brzyzek/horologe/README.md

# horologe
A watch utilizing an ESP32 processor.
