brzyzek/horologe/2_HARDWARE/02_BOM/embd-watch-BOM-0001.ods

LEVEL | FIND NUMBER | PART NUMBER | PART DESCRIPTION | REF DES | QUANTITY | UOM | UNIT PRICE | PRICE | VENDOR LINK | PHASE | COMMENT
1 | 0001 | brzk-wt-001 | Embedded Watch Prototype |  | 1 | EACH |  | 48.226468 | N/A | PROTOTYPE
2 | 0001 | brzk-wt-001-pcb | Embedded Watch Prototype Printed Circuit Board |  | 1 | EACH | TBD | TBD | TBD | PROTOTYPE
2 | 0002 | ESP32-WROOM-32E-N4 | ESP32 Module /w PCB Antenna | U1 | 1 | EACH | $2.50 | $2.50 | https://www.digikey.com/en/products/detail/espressif-systems/ESP32-WROOM-32E-N4/11613125 | ACTIVE | NOT IN STOCK DIGIKEY!
2 | 0003 | XC9265A331MR-G | Voltage Regulator - 3.3V, DC-DC Converter | U2 | 1 | EACH | $1.46 | $1.46 | https://www.mouser.com/ProductDetail/Torex-Semiconductor/XC9265A331MR-G?qs=AsjdqWjXhJ9U1u7bKcUHSA%3D%3D | ACTIVE | CHECK CURRENT
2 | 0004 | MAX1811ESA+ | Battery Charger IC Lithium Ion | U3 | 1 | EACH | $4.82 | $4.82 | https://www.digikey.com/en/products/detail/analog-devices-inc-maxim-integrated/MAX1811ESA/1513383 | ACTIVE
2 | 0005 | TLV840MAPL36DBVRQ1 | Battery Supervisor IC | U4 | 1 | EACH | $0.85 | $0.85 | https://www.mouser.com/ProductDetail/Texas-Instruments/TLV840MAPL36DBVRQ1?qs=TuK3vfAjtkUvm%2FFmAPUHzQ%3D%3D | ACTIVE
2 | 0006 | DMC2400UV-7 | MOSFET N/P 2 CHANNEL PAIR IC | U5 | 1 | EACH | $0.40 | $0.40 | https://www.digikey.com/en/products/detail/diodes-incorporated/DMC2400UV-7/2918383 | ACTIVE | NEED TO ADD RESISTORS
2 | 0007 | LSM6DSMTR | IMU ACCEL/GYRO I2C/SPI IC | U6 | 1 | EACH | $4.45 | $4.45 | https://www.digikey.com/en/products/detail/stmicroelectronics/LSM6DSMTR/6192777 | ACTIVE
2 | 0008 | LPS22DFTR | Pressure Sensor | U7 | 1 | EACH | $4.19 | $4.19 | https://www.mouser.com/ProductDetail/STMicroelectronics/LPS22DFTR?qs=XAiT9M5g4x%2FrfsCWzyhaPw%3D%3D | ACTIVE
2 | 0009 | JS102011SAQN | SPDT SLIDE SWITCH RIGHT ANGLE | S1 | 1 | EACH | $0.71 | $0.71 | https://www.digikey.com/en/products/detail/c-k/JS102011SAQN/1640095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 | ACTIVE
2
2 |  | SM13B-GHS-TB(LF)(SN) | GH1.25 13 PIN 1.25MM CONNECTOR (FOR SCREEN MODULE) | J1 | 1 | EACH | 0.036468 | $0.04 | https://www.digikey.com/en/products/detail/jst-sales-america-inc/SM13B-GHS-TB-LF-SN/807797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 | ACTIVE | MAY NEED TO FIND ALTERNATE (STRAIGHT SOLDER?)
2 |  | USB4056-03-A | USB-C 3.2 CONNECTOR | J2 | 1 | EACH | $0.97 | $0.97 | https://www.digikey.com/en/products/detail/gct/USB4056-03-A/14638038 | ACTIVE
2 |  | GRPB052VWVN-RC | 10 PIN HEADER 2 ROW 1.27MM PITCH (JTAG) | J3 | 1 | EACH | $0.73 | $0.73 | https://www.digikey.com/en/products/detail/sullins-connector-solutions/GRPB052VWVN-RC/1786455 | ACTIVE
2
2
2
2 | 0201 | 24155 | 1.28 Inch 240x240p Screen Module /w Capacative Touch Sensor |  | 1 | EACH | $18.99 | $18.99 | https://www.waveshare.com/1.28inch-touch-lcd.htm | ACTIVE
2 | 0202 | LP851719JU+PCM+2 WIRES 50MM | LIPO 3.7V 180MAH BATTERY |  | 1 | EACH | $8.12 | $8.12 | https://www.digikey.com/en/products/detail/jauch-quartz/LP851719JU-PCM-2-WIRES-50MM/9560975 | ACTIVE
2 | 1001 | brzk-wt-001-sch | Embedded Watch Circuit Card Assembly Schematic |  | 0 | REF | N/A | N/A | N/A | PROTOTYPE
 |  |  | LSM6DSM
