brzyzek/horologe/2_HARDWARE/02_BOM/embd-watch-BOM-0002.ods

LEVEL | FIND NUMBER | PART NUMBER | PART DESCRIPTION | REF DES | QUANTITY | UOM | UNIT PRICE | PRICE | VENDOR LINK | PHASE | COMMENT
RC0603FR-070RL | 0001 | brzk-wt-001 | Embedded Watch Prototype |  | 1 | EACH |  | 55.496468 | N/A | PROTOTYPE
2 | 0001 | brzk-wt-001-pcb | Embedded Watch Prototype Printed Circuit Board |  | 1 | EACH | TBD | TBD | TBD | PROTOTYPE
2 | 0002 | ESP32-WROOM-32E-N4 | ESP32 Module /w PCB Antenna | U1 | 1 | EACH | $2.50 | $2.50 | https://www.digikey.com/en/products/detail/espressif-systems/ESP32-WROOM-32E-N4/11613125 | ACTIVE | NOT IN STOCK DIGIKEY!
2 | 0003 | XC9236A33CMR-G | Voltage Regulator - 3.3V, DC-DC Converter | U2 | 1 | EACH | $1.83 | $1.83 | https://www.mouser.com/ProductDetail/Torex-Semiconductor/XC9236A33CMR-G?qs=AsjdqWjXhJ%2FEQcsIJZieHw%3D%3D | ACTIVE | CHECK CURRENT
2 | 0004 | MAX1811ESA+ | Battery Charger IC Lithium Ion | U3 | 1 | EACH | $4.82 | $4.82 | https://www.digikey.com/en/products/detail/analog-devices-inc-maxim-integrated/MAX1811ESA/1513383 | ACTIVE
2 | 0005 | TLV840MAPL36DBVRQ1 | Battery Supervisor IC | U4 | 1 | EACH | $0.85 | $0.85 | https://www.mouser.com/ProductDetail/Texas-Instruments/TLV840MAPL36DBVRQ1?qs=TuK3vfAjtkUvm%2FFmAPUHzQ%3D%3D | ACTIVE
2 | 0006 | DMC2400UV-7 | MOSFET N/P 2 CHANNEL PAIR IC | U5 | 1 | EACH | $0.40 | $0.40 | https://www.digikey.com/en/products/detail/diodes-incorporated/DMC2400UV-7/2918383 | ACTIVE | NEED TO ADD RESISTORS
2 | 0007 | LSM6DSMTR | IMU ACCEL/GYRO I2C/SPI IC | U6 | 1 | EACH | $4.45 | $4.45 | https://www.digikey.com/en/products/detail/stmicroelectronics/LSM6DSMTR/6192777 | ACTIVE
2 | 0008 | LPS22DFTR | Pressure Sensor | U7 | 1 | EACH | $4.19 | $4.19 | https://www.mouser.com/ProductDetail/STMicroelectronics/LPS22DFTR?qs=XAiT9M5g4x%2FrfsCWzyhaPw%3D%3D | ACTIVE
2 | 0009 | JS102011SAQN | SPDT SLIDE SWITCH RIGHT ANGLE | S1 | 1 | EACH | $0.71 | $0.71 | https://www.digikey.com/en/products/detail/c-k/JS102011SAQN/1640095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 | ACTIVE
2
2 | 0010 | SM13B-GHS-TB(LF)(SN) | GH1.25 13 PIN 1.25MM CONNECTOR (FOR SCREEN MODULE) | J1 | 1 | EACH | 0.036468 | $0.04 | https://www.digikey.com/en/products/detail/jst-sales-america-inc/SM13B-GHS-TB-LF-SN/807797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 | ACTIVE | MAY NEED TO FIND ALTERNATE (STRAIGHT SOLDER?)
2 | 0011 | USB4056-03-A | USB-C 3.2 CONNECTOR | J2 | 1 | EACH | $0.97 | $0.97 | https://www.digikey.com/en/products/detail/gct/USB4056-03-A/14638038 | ACTIVE
2 | 0012 | GRPB052VWVN-RC | 10 PIN HEADER 2 ROW 1.27MM PITCH (JTAG) | J3 | 1 | EACH | $0.73 | $0.73 | https://www.digikey.com/en/products/detail/sullins-connector-solutions/GRPB052VWVN-RC/1786455 | ACTIVE
2
2 |  |  |  |  |  |  |  |  |  | ACTIVE
2 | 0100 | RC0603FR-075K1L | RESISTOR, 0603, 5.1K | R1,2 | 2 | EACH | $0.10 | $0.20 | https://www.mouser.com/ProductDetail/YAGEO/RC0603FR-075K1L | ACTIVE
2 | 0101 | RC0603FR-0710KL | RESISTOR, 0603, 10K | R3,4,5,17,20 | 5 | EACH | $0.10 | $0.50 | https://www.mouser.com/ProductDetail/YAGEO/RC0603FR-0710KL?qs=grNVn54RoB%252B3GtjbJj3wJQ%3D%3D | ACTIVE
2 | 0102 | RC0603FR-071KL | RESISTOR, 0603, 1K | R10,11 | 2 | EACH | $0.10 | $0.20 | https://www.mouser.com/ProductDetail/YAGEO/RC0603FR-071KL?qs=VU8sRB4EgwApHsk4rF%2F3zg%3D%3D | ACTIVE
2 | 0103 | RC0603FR-071ML | RESISTOR, 0603, 1M | R6,9 | 2 | EACH | $0.10 | $0.20 | https://www.mouser.com/ProductDetail/YAGEO/RC0603FR-071ML?qs=VU8sRB4EgwDPceeQKB324w%3D%3D | ACTIVE
2 | 0104 | RC0603FR-071M5L | RESISTOR, 0603, 1.5M | R7 | 1 | EACH | $0.10 | $0.10 | https://www.mouser.com/ProductDetail/YAGEO/RC0603FR-071M5L?qs=VU8sRB4EgwAP38Z8qzPx9Q%3D%3D | ACTIVE
2 | 0105 | RC0603FR-07180KL | RESISTOR, 0603, 180K | R8 | 1 | EACH | $0.10 | $0.10 | https://www.mouser.com/ProductDetail/YAGEO/RC0603FR-07180KL?qs=O8xBZ6PjLLQzC0EvPkFa3w%3D%3D | ACTIVE
2 | 0106 | RC0603FR-070RL | RESISTOR, 0603, 0R | R12,13,14,15,16,18,19 | 7 | EACH | $0.10 | $0.70 | https://www.mouser.com/ProductDetail/YAGEO/RC0603FR-070RL?qs=sGAEpiMZZMvdGkrng054t8AJgcdMkx7xZdNoPBh6LNc%3D | ACTIVE
2 | 0108 | NR4018T4R7M | INDUCTOR, NR4018, 4.7UH | L1 | 1 | EACH | $0.35 | $0.35 | https://www.digikey.com/en/products/detail/taiyo-yuden/NR4018T4R7M/958054 | END OF LIFE
2 | 0109 | CL21A475KPFNNNF | CAPACITOR, 0805, 4.7UF | C1,3,8,12 | 4 | EACH | $0.10 | $0.40 | https://www.mouser.com/ProductDetail/Samsung-Electro-Mechanics/CL21A475KPFNNNF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 | ACTIVE
 | 0110 | CL21B225KPFNNNE | CAPACITOR, 0805, 2.2UF | C2 | 1 | EACH | $0.10 | $0.10 | https://www.mouser.com/ProductDetail/Samsung-Electro-Mechanics/CL21B225KPFNNNE?qs=349EhDEZ59oD5pfAKZ0J0g%3D%3D | ACTIVE
 | 0111 | CL21A106KQFNNNE | CAPACITOR, 0805, 10UF | C4 | 1 | EACH | $0.10 | $0.10 | https://www.mouser.com/ProductDetail/Samsung-Electro-Mechanics/CL21A106KQFNNNE?qs=349EhDEZ59r7ASo3FF1ozQ%3D%3D | ACTIVE
 | 0112 | CL21B104KACNNND | CAPACITOR, 0805, 0.1UF | C5,7,9,10,11 | 5 | EACH | $0.10 | $0.50 | https://www.mouser.com/ProductDetail/Samsung-Electro-Mechanics/CL21B104KACNNND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 | ACTIVE
 | 0113 | CL21A106KQFNNNE | CAPACITOR, 0805, 22UF | C6 | 1 | EACH | $0.10 | $0.10 | https://www.mouser.com/ProductDetail/Samsung-Electro-Mechanics/CL21A106KQFNNNE?qs=349EhDEZ59r7ASo3FF1ozQ%3D%3D | ACTIVE
2 | 0201 | 24155 | 1.28 Inch 240x240p Screen Module /w Capacative Touch Sensor |  | 1 | EACH | $18.99 | $18.99 | https://www.waveshare.com/1.28inch-touch-lcd.htm | ACTIVE
2 | 0202 | LP102530JU+PCM+2 WIRES 50MM | LIPO 3.7V 680MAH BATTERY |  | 1 | EACH | $11.47 | $11.47 | https://www.digikey.com/en/products/detail/jauch-quartz/LP102530JU-PCM-2-WIRES-50MM/9560985 | ACTIVE
2 | 1001 | brzk-wt-001-sch | Embedded Watch Circuit Card Assembly Schematic |  | 0 | REF | N/A | N/A | N/A | PROTOTYPE
 |  |  | LSM6DSM
