brzyzek/horologe/2_HARDWARE/03_PCB/watch-0001.kicad_pcb

## KiCad design 2_HARDWARE/03_PCB/watch-0001.kicad_pcb (2025-02-06)

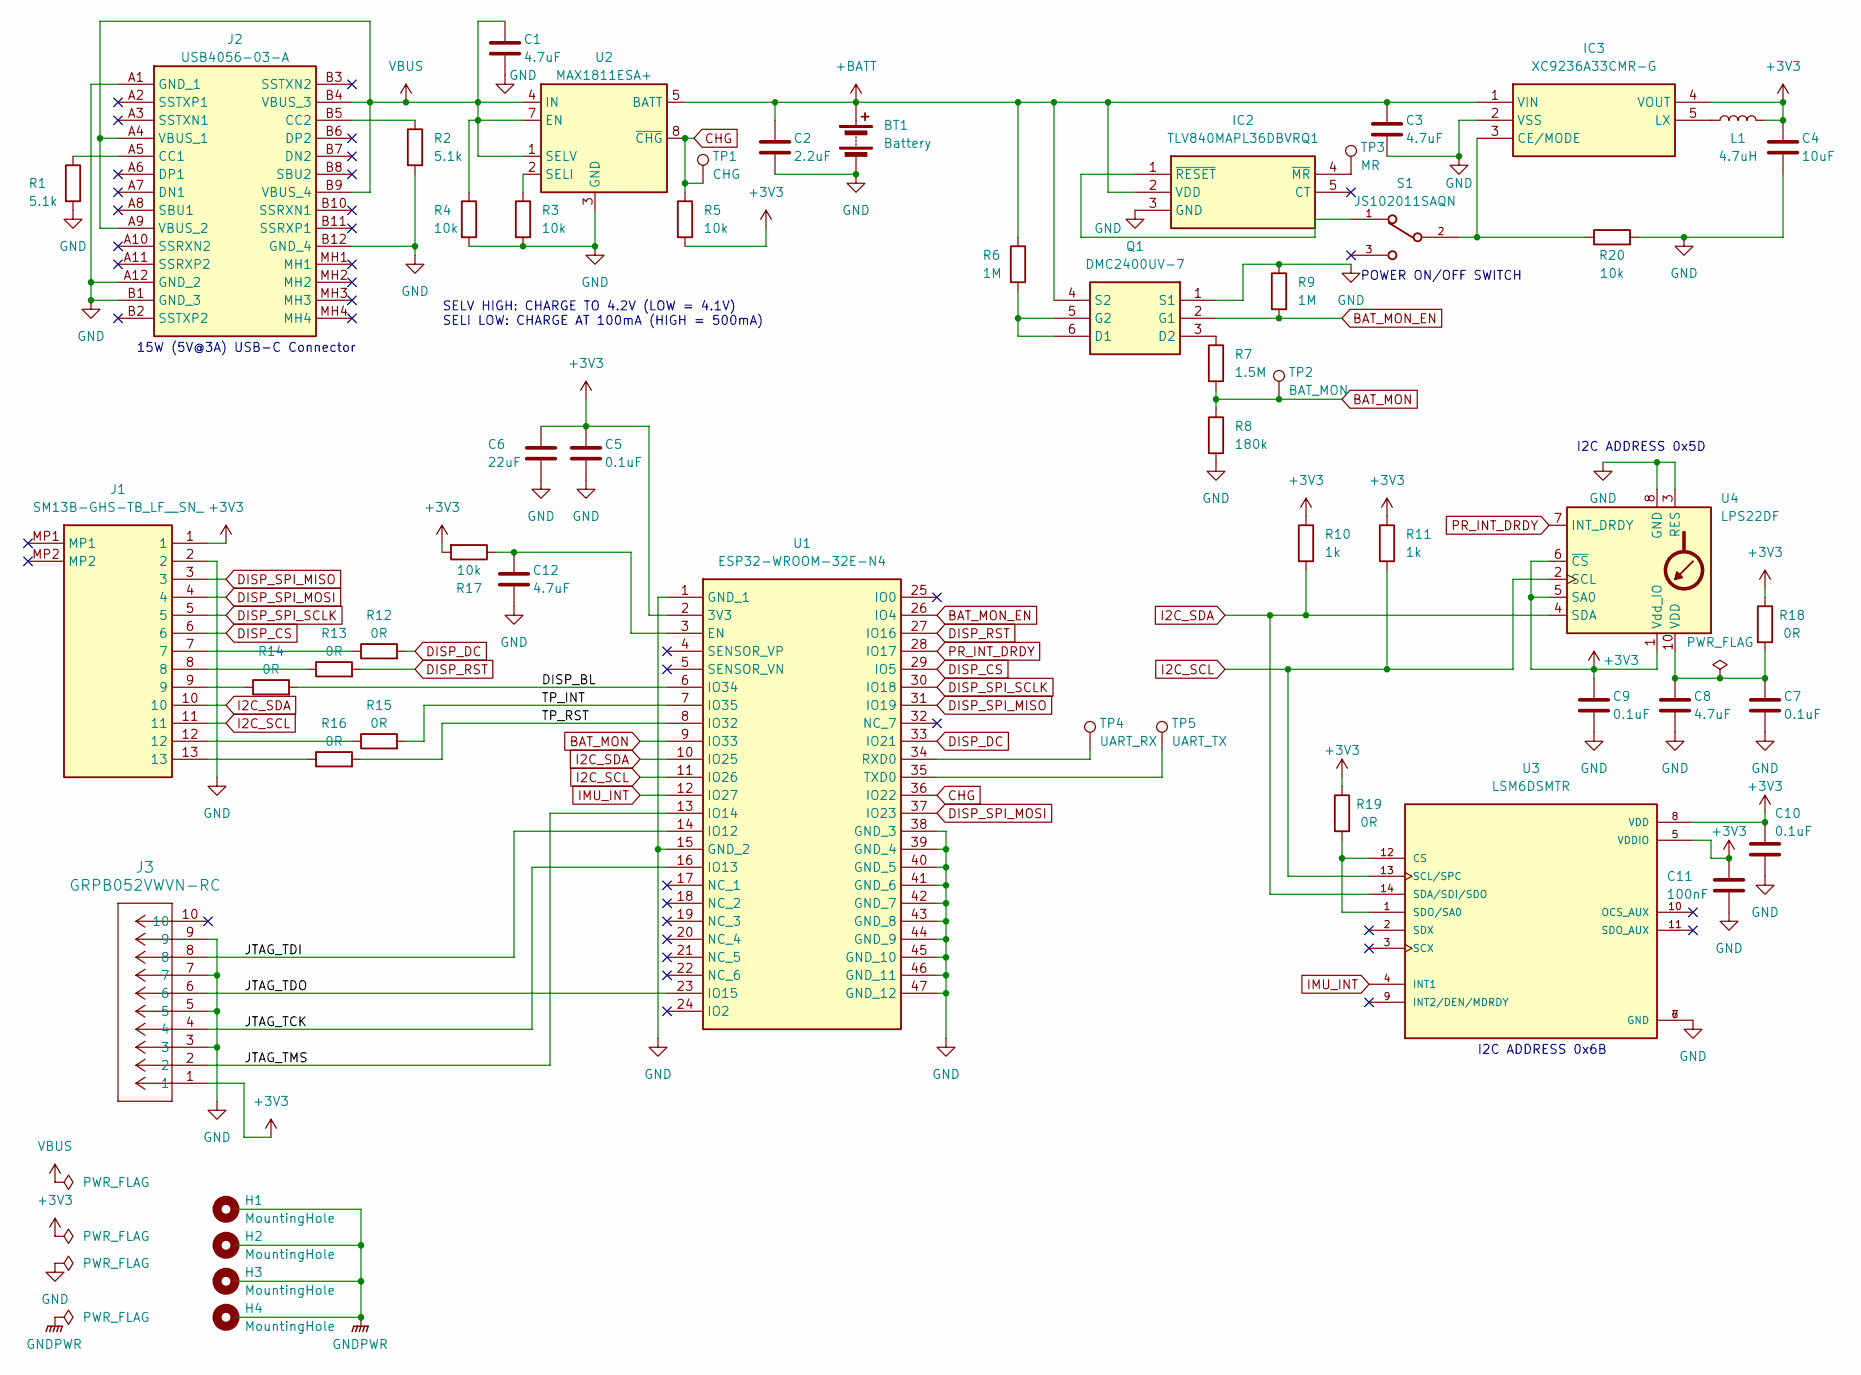
[picture p1: schematic watch-0001.kicad_sch]

Parts:
BT1: Battery; BAT_DUAL_1MM_TESTPOINTS
C1, C3, C8, C12: 4.7uF; C_0805_2012Metric
C2: 2.2uF; C_0805_2012Metric
C4: 10uF; C_0805_2012Metric
C5, C7, C9, C10: 0.1uF; C_0805_2012Metric
C6: 22uF; C_0805_2012Metric
C11: 100nF; C_0805_2012Metric
H1, H2, H3, H4: MountingHole; MountingHole_2.2mm_M2_DIN965_Pad
IC2: TLV840MAPL36DBVRQ1; SOT95P280X145-5N; Manufacturer_Part_Number TLV840MAPL36DBVRQ1; Mouser Part Number 595-V840MAPL36DBVRQ1
IC3: XC9236A33CMR-G; SOT95P280X130-5N; Manufacturer_Part_Number XC9236A33CMR-G; Mouser Part Number 865-XC9236A33CMR-G
J1: SM13B-GHS-TB_LF__SN_; SM13BGHSTBLFSN; Manufacturer_Part_Number SM13B-GHS-TB(LF)(SN)
J2: USB4056-03-A; USB405603A; Manufacturer_Part_Number USB4056-03-A; Mouser Part Number 640-USB4056-03-A
J3: GRPB052VWVN-RC; CONN_GRPB052VWVN-RC_SUL
L1: 4.7uH; IND_TAIYO_NR4018_TAY
Q1: DMC2400UV-7; SOTFL50P162X60-6N; Manufacturer_Part_Number DMC2400UV-7; Mouser Part Number 621-DMC2400UV-7
R1, R2: 5.1k; R_0603_1608Metric
R3, R4, R5, R17, R20: 10k; R_0603_1608Metric
R6, R9: 1M; R_0603_1608Metric
R7: 1.5M; R_0603_1608Metric
R8: 180k; R_0603_1608Metric
R10, R11: 1k; R_0603_1608Metric
R12, R13, R14, R15, R16, R18, R19: 0R; R_0603_1608Metric
S1: JS102011SAQN; SW_JS102011SAQN
TP1: CHG; TestPoint_Pad_D1.0mm
TP2: BAT_MON; TestPoint_Pad_D1.0mm
TP3: MR; TestPoint_Pad_D1.0mm
TP4: UART_RX; TestPoint_Pad_D1.0mm
TP5: UART_TX; TestPoint_Pad_D1.0mm
U1: ESP32-WROOM-32E-N4; ESP32WROOM32EN4; Manufacturer_Part_Number ESP32-WROOM-32E-N4; Mouser Part Number 356-ESP32WRM32E132PH
U2: MAX1811ESA+; SOIC-8_3.9x4.9mm_P1.27mm
U3: LSM6DSMTR; PQFN50P300X250X86-14N; PARTREV Rev 7
U4: LPS22DF; ST_HLGA-10_2x2mm_P0.5mm_LayoutBorder3x2y

Connections:
+3V3: C4.1, C5.1, C6.1, C9.1, C10.1, C11.1, IC3.4 (VOUT), J1.1, J3.1, L1.2, R5.2, R10.1, R11.1, R17.2, R18.1, R19.1, U1.2 (3V3), U3.5 (VDDIO), U3.8 (VDD), U4.1 (Vdd_IO), U4.5 (SA0), U4.6 (~CS)
+BATT: BT1.1 (+), C2.1, C3.1, IC2.2 (VDD), IC3.1 (VIN), Q1.4 (S2), R6.1, U2.5 (BATT)
/DISP_BL: R14.2, U1.6 (IO34)
/JTAG_TCK: J3.4, U1.16 (IO13)
/JTAG_TDI: J3.8, U1.14 (IO12)
/JTAG_TDO: J3.6, U1.23 (IO15)
/JTAG_TMS: J3.2, U1.13 (IO14)
/TP_INT: R15.2, U1.7 (IO35)
/TP_RST: R16.2, U1.8 (IO32)
BAT_MON: R7.2, R8.1, TP2.1, U1.9 (IO33)
BAT_MON_EN: Q1.2 (G1), R9.2, U1.26 (IO4)
CHG: R5.1, TP1.1, U1.36 (IO22), U2.8 (~CHG)
DISP_CS: J1.6, U1.29 (IO5)
DISP_DC: R12.2, U1.33 (IO21)
DISP_RST: R13.2, U1.27 (IO16)
DISP_SPI_MISO: J1.3, U1.31 (IO19)
DISP_SPI_MOSI: J1.4, U1.37 (IO23)
DISP_SPI_SCLK: J1.5, U1.30 (IO18)
GND: BT1.2 (-), C1.2, C2.2, C3.2, C4.2, C5.2, C6.2, C7.2, C8.2, C9.2, C10.2, C11.2, C12.2, IC2.3 (GND), IC3.2 (VSS), J1.2, J2.A1 (GND_1), J2.A12 (GND_2), J2.B1 (GND_3), J2.B12 (GND_4), J3.3, J3.5, J3.7, J3.9, Q1.1 (S1), R1.2, R2.2, R3.2, R4.2, R8.2, R9.1, R20.2, U1.1 (GND_1), U1.15 (GND_2), U1.38 (GND_3), U1.39 (GND_4), U1.40 (GND_5), U1.41 (GND_6), U1.42 (GND_7), U1.43 (GND_8), U1.44 (GND_9), U1.45 (GND_10), U1.46 (GND_11), U1.47 (GND_12), U2.3 (GND), U2.6 (GND), U3.6 (GND), U3.7 (GND), U4.3 (RES), U4.8 (GND), U4.9 (GND)
I2C_SCL: J1.11, R11.2, U1.11 (IO26), U3.13 (SCL/SPC), U4.2 (SCL)
I2C_SDA: J1.10, R10.2, U1.10 (IO25), U3.14 (SDA/SDI/SDO), U4.4 (SDA)
IMU_INT: U1.12 (IO27), U3.4 (INT1)
unnamed: IC2.4 (~MR), TP3.1
unnamed: IC2.1 (~RESET), S1.1
unnamed: IC3.3 (CE/MODE), R20.1, S1.2
unnamed: IC3.5 (LX), L1.1
unnamed: J1.7, R12.1
unnamed: J1.8, R13.1
unnamed: J1.9, R14.1
unnamed: J1.12, R15.1
unnamed: J1.13, R16.1
unnamed: J2.A5 (CC1), R1.1
unnamed: J2.B5 (CC2), R2.1
unnamed: Q1.5 (G2), Q1.6 (D1), R6.2
unnamed: Q1.3 (D2), R7.1
unnamed: C12.1, R17.1, U1.3 (EN)
unnamed: TP4.1, U1.34 (RXD0)
unnamed: TP5.1, U1.35 (TXD0)
unnamed: R3.1, U2.2 (SELI)
unnamed: R19.2, U3.1 (SDO/SA0), U3.12 (CS)
unnamed: C7.1, C8.1, R18.2, U4.10 (VDD)
PR_INT_DRDY: U1.28 (IO17), U4.7 (INT_DRDY)
VBUS: C1.1, J2.A4 (VBUS_1), J2.A9 (VBUS_2), J2.B4 (VBUS_3), J2.B9 (VBUS_4), R4.1, U2.1 (SELV), U2.4 (IN), U2.7 (EN)

Notes on the sheet:
SELV HIGH: CHARGE TO 4.2V (LOW = 4.1V) SELI LOW: CHARGE AT 100mA (HIGH = 500mA)
I2C ADDRESS 0x5D
15W (5V@3A) USB-C Connector
POWER ON/OFF SWITCH
I2C ADDRESS 0x6B

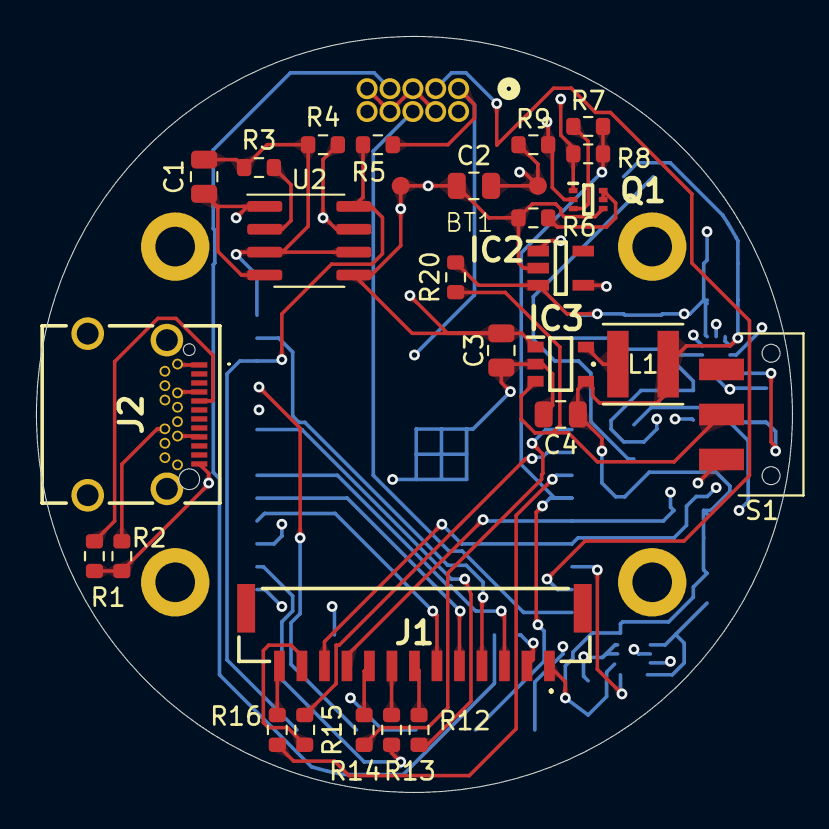
[picture p2: board watch-0001.kicad_pcb from above]

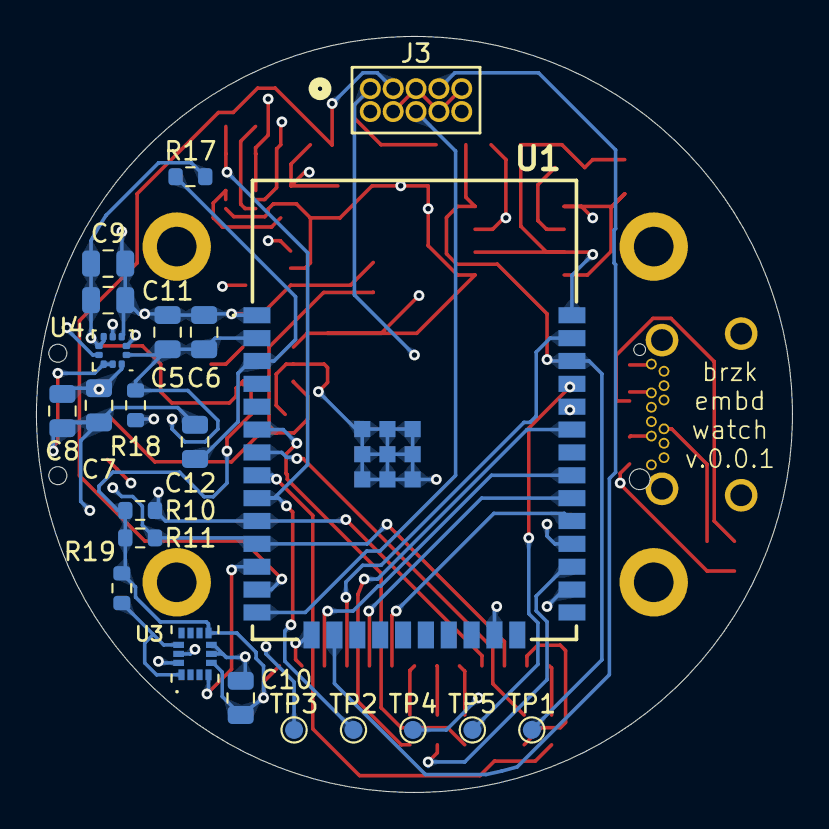
[picture p3: board watch-0001.kicad_pcb from below]

Board: 4 copper layers, 42.0 x 42.0 mm, 54 parts (22 on the bottom side), 43 nets.
