brzyzek/horologe/3_SOFTWARE/modules/gui.c

#include "gui.h"


SemaphoreHandle_t xGuiSemaphore;
void clock_ui_update_timer(lv_timer_t * timer);

void guiTask(void *pvParameter) {

    (void) pvParameter;
    xGuiSemaphore = xSemaphoreCreateMutex();

    lv_init();

    /* Initialize SPI or I2C bus used by the drivers */
    lvgl_driver_init();
    
    lv_color_t* buf1 = heap_caps_malloc(DISP_BUF_SIZE * sizeof(lv_color_t), MALLOC_CAP_DMA);
    assert(buf1 != NULL);

    /* Use double buffered when not working with monochrome displays */
#ifndef CONFIG_LV_TFT_DISPLAY_MONOCHROME
    lv_color_t* buf2 = heap_caps_malloc(DISP_BUF_SIZE * sizeof(lv_color_t), MALLOC_CAP_DMA);
    assert(buf2 != NULL);
#else
    static lv_color_t *buf2 = NULL;
#endif

    static lv_disp_draw_buf_t disp_buf;

    uint32_t size_in_px = DISP_BUF_SIZE;

#if defined CONFIG_LV_TFT_DISPLAY_CONTROLLER_IL3820         \
    || defined CONFIG_LV_TFT_DISPLAY_CONTROLLER_JD79653A    \
    || defined CONFIG_LV_TFT_DISPLAY_CONTROLLER_UC8151D     \
    || defined CONFIG_LV_TFT_DISPLAY_CONTROLLER_SSD1306

    /* Actual size in pixels, not bytes. */
    size_in_px *= 8;
#endif

    /* Initialize the working buffer depending on the selected display.
     * NOTE: buf2 == NULL when using monochrome displays. */
    lv_disp_draw_buf_init(&disp_buf, buf1, buf2, size_in_px);

    lv_disp_drv_t disp_drv;
    lv_disp_drv_init(&disp_drv);
    disp_drv.flush_cb = disp_driver_flush;
    disp_drv.hor_res = 240;
    disp_drv.ver_res = 240;

#if defined CONFIG_DISPLAY_ORIENTATION_PORTRAIT || defined CONFIG_DISPLAY_ORIENTATION_PORTRAIT_INVERTED
    disp_drv.rotated = 1;
#endif

    /* When using a monochrome display we need to register the callbacks:
     * - rounder_cb
     * - set_px_cb */
#ifdef CONFIG_LV_TFT_DISPLAY_MONOCHROME
    disp_drv.rounder_cb = disp_driver_rounder;
    disp_drv.set_px_cb = disp_driver_set_px;
#endif

    disp_drv.draw_buf = &disp_buf;
    lv_disp_drv_register(&disp_drv);

    /* Register an input device when enabled on the menuconfig */
#if CONFIG_LV_TOUCH_CONTROLLER != TOUCH_CONTROLLER_NONE
    lv_indev_drv_t indev_drv;
    lv_indev_drv_init(&indev_drv);
    indev_drv.read_cb = touch_driver_read;
    indev_drv.type = LV_INDEV_TYPE_POINTER;
    lv_indev_drv_register(&indev_drv);
#endif

    /* Create and start a periodic timer interrupt to call lv_tick_inc */
    const esp_timer_create_args_t periodic_timer_args = {
        .callback = &lv_tick_task,
        .name = "periodic_gui"
    };
    esp_timer_handle_t periodic_timer;
    ESP_ERROR_CHECK(esp_timer_create(&periodic_timer_args, &periodic_timer));
    ESP_ERROR_CHECK(esp_timer_start_periodic(periodic_timer, LV_TICK_PERIOD_MS * 100));

    /* Initialize UI (Old Demo Component) */
    ui_init();

    /* Initialize LVGL Timers (Tasks)*/
    // DEV: May need to create some kind of blocking scheme to make sure that ui_data is present before we update.
    lv_timer_t * timer = lv_timer_create(clock_ui_update_timer, 1000,  &ui_str_data);
    while (1) {
        /* Delay 1 tick (assumes FreeRTOS tick is 10ms */
        vTaskDelay(pdMS_TO_TICKS(10));


        /* Try to take the semaphore, call lvgl related function on success */
        if (pdTRUE == xSemaphoreTake(xGuiSemaphore, portMAX_DELAY)) {
            lv_task_handler();
            xSemaphoreGive(xGuiSemaphore);
       }
    }

    /* A task should NEVER return */
    free(buf1);
#ifndef CONFIG_LV_TFT_DISPLAY_MONOCHROME
    free(buf2);
#endif
    vTaskDelete(NULL);
}

void lv_tick_task(void *arg) {
    (void) arg;

    lv_tick_inc(LV_TICK_PERIOD_MS);
}

void clock_ui_update_timer(lv_timer_t * timer){
    ui_str* data = timer->user_data;
    lv_label_set_text(ui_TIMETXT, data->time_buf);
    lv_label_set_text(ui_DAYTXT, data->day_name_buf);
    lv_label_set_text(ui_DATETXT, data->date_buf);
    lv_label_set_text(ui_AMPMTXT, data->AMPM_buf);
}
